xeoncesta/8085-POV/IMG_20170409_183915.jpg

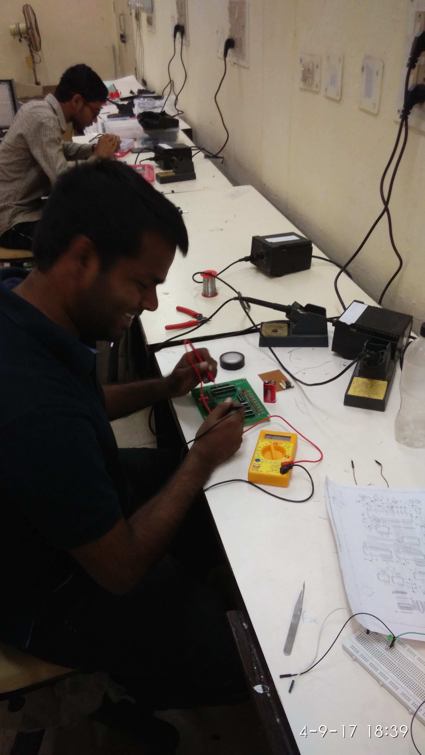
IMG_20170409_183915.jpg
