xeoncesta/8085-POV/README.md

# 8085-POV
Assembly Code and hardware implementation for 8085 MPU based POV Display.
