xeoncesta/8085-POV/IMG_20170522_213831.jpg

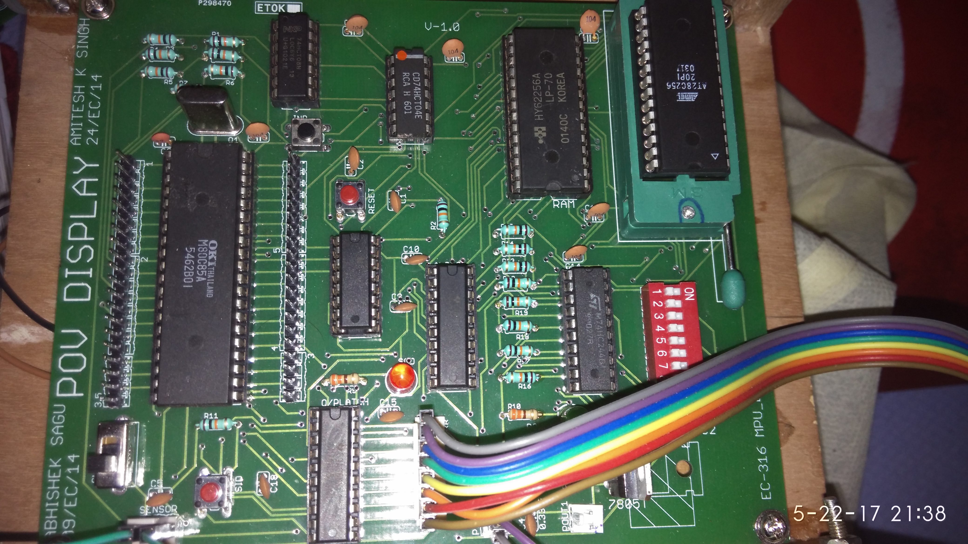
IMG_20170522_213831.jpg
