xeoncesta/8085-POV/ledunit.brd

## EAGLE design ledunit.brd (2017-05-22)

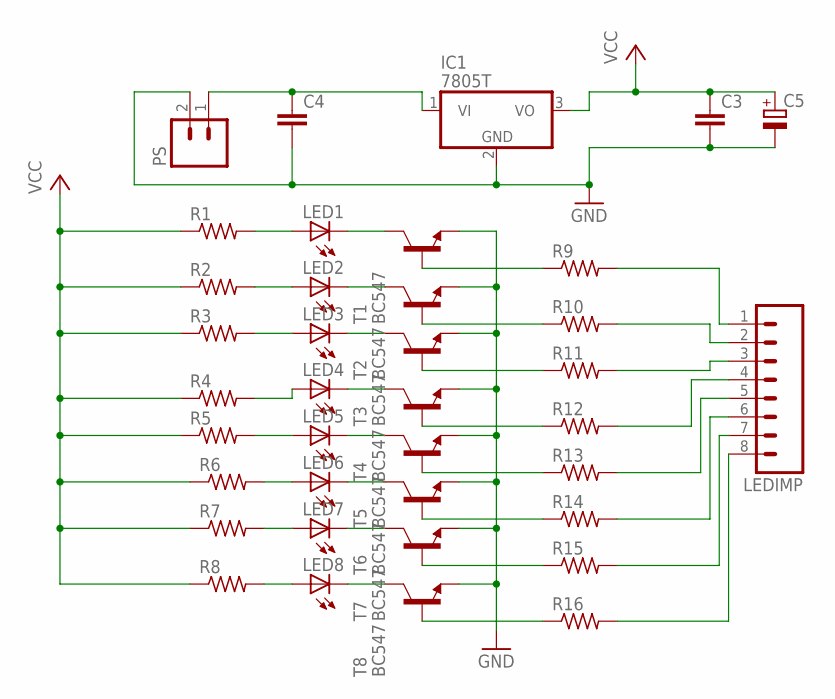
[picture p10: schematic ledunit.sch]

Parts:
C3, C4: C-EU025-024X044; C025-024X044
C5: CPOL-EUE2,5-6E; E2,5-6E
IC1: 7805T; TO220H
LED1, LED2, LED3, LED4, LED5, LED6, LED7, LED8: LED5MM
LEDIMP: M08; 08P
PS: M02; 02P
R1, R2, R3, R4, R5, R6, R7, R8, R9, R10, R11, R12, R13, R14, R15, R16: R-US_0204/7; 0204/7
T1, T2, T3, T4, T5, T6, T7, T8: BC547; TO92

Connections:
GND: C3.2, C4.2, C5.-, IC1.2 (GND), PS.2, T1.1 (E), T2.1 (E), T3.1 (E), T4.1 (E), T5.1 (E), T6.1 (E), T7.1 (E), T8.1 (E)
unnamed: LED8.A, R8.2
unnamed: LED7.A, R7.2
unnamed: LED6.A, R6.2
unnamed: LED5.A, R5.2
unnamed: LED4.A, R4.2
unnamed: LED3.A, R3.2
unnamed: LED2.A, R2.2
unnamed: LED1.A, R1.2
unnamed: LED1.K (C), T1.3 (C)
unnamed: LED2.K (C), T2.3 (C)
unnamed: LED3.K (C), T3.3 (C)
unnamed: LED4.K (C), T4.3 (C)
unnamed: LED5.K (C), T5.3 (C)
unnamed: LED6.K (C), T6.3 (C)
unnamed: LED7.K (C), T7.3 (C)
unnamed: LED8.K (C), T8.3 (C)
unnamed: R9.1, T1.2 (B)
unnamed: R10.1, T2.2 (B)
unnamed: R11.1, T3.2 (B)
unnamed: R12.1, T4.2 (B)
unnamed: R13.1, T5.2 (B)
unnamed: R14.1, T6.2 (B)
unnamed: R15.1, T7.2 (B)
unnamed: R16.1, T8.2 (B)
unnamed: LEDIMP.1, R9.2
unnamed: LEDIMP.2, R10.2
unnamed: LEDIMP.3, R11.2
unnamed: LEDIMP.4, R12.2
unnamed: LEDIMP.5, R13.2
unnamed: LEDIMP.6, R14.2
unnamed: LEDIMP.7, R15.2
unnamed: LEDIMP.8, R16.2
unnamed: C4.1, IC1.1 (VI), PS.1
VCC: C3.1, C5.+, IC1.3 (VO), R1.1, R2.1, R3.1, R4.1, R5.1, R6.1, R7.1, R8.1

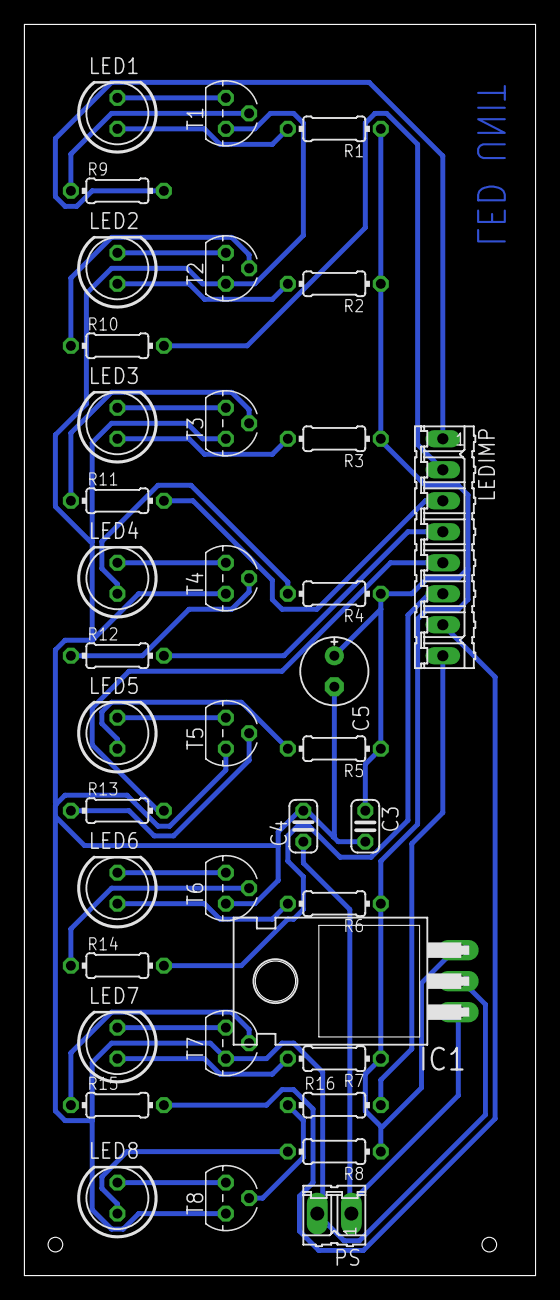
[picture p11: board ledunit.brd from above]

Board: 2 copper layers, 41.9 x 102.5 mm, 38 parts (0 on the bottom side), 35 nets.
