xeoncesta/8085-POV/POV_2.0.brd

## EAGLE design POV_2.0.brd (2017-05-22)

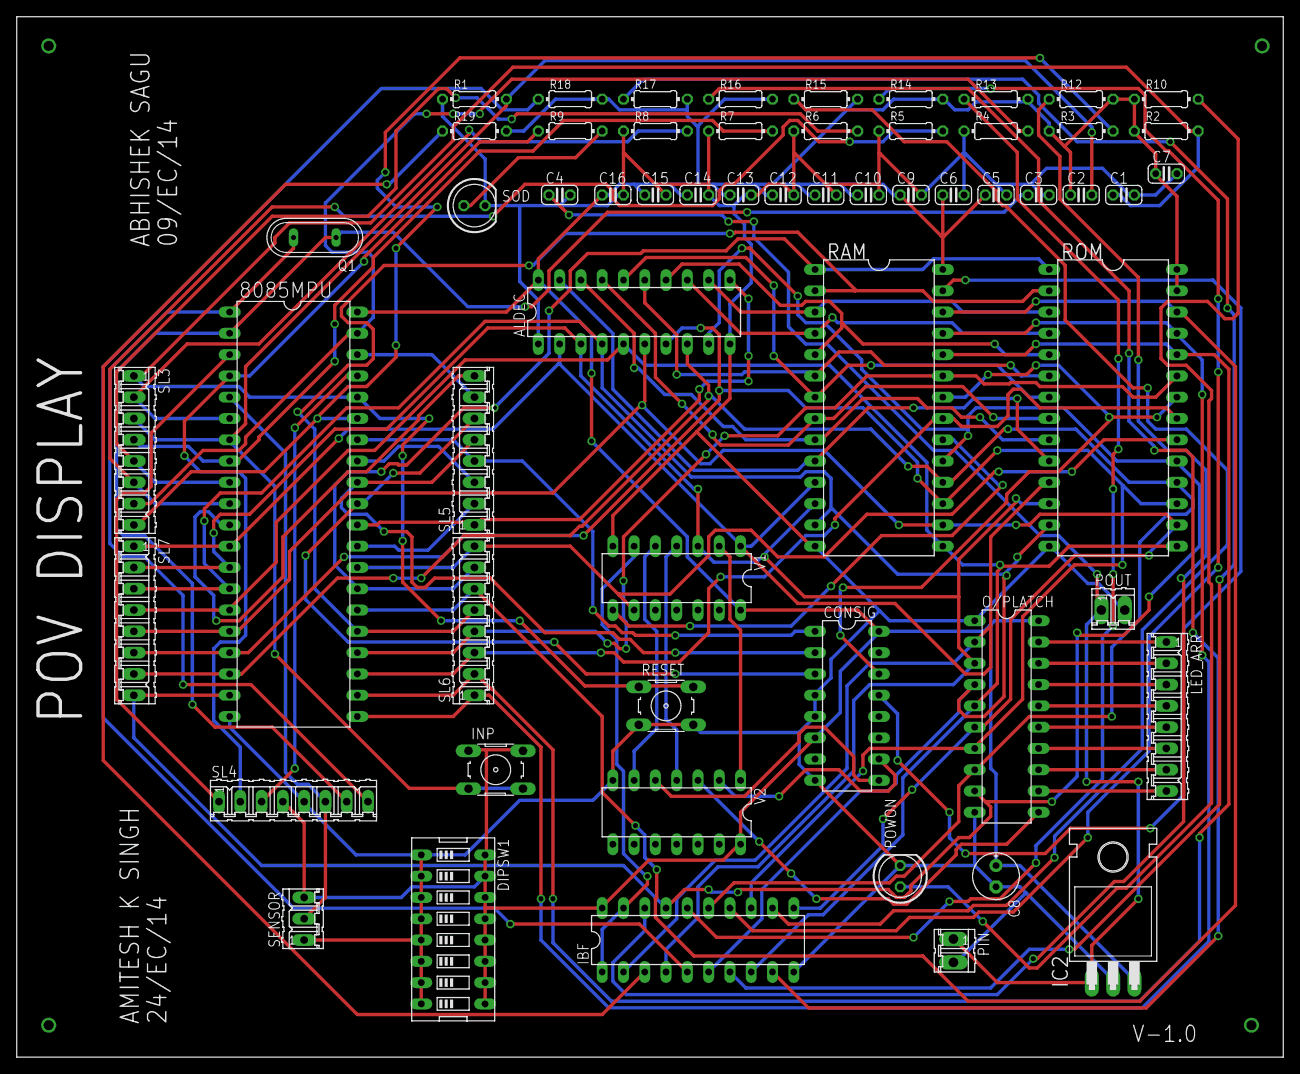
[picture p12: board POV_2.0.brd from above]

Board: 2 copper layers, 151.1 x 124.1 mm, 59 parts (0 on the bottom side), 77 nets.

Parts:
8085MPU: DIL40
ALDEC: 74HCT573N; DIL20
C1, C2, C3, C5, C6, C9, C10, C11, C12, C13, C14, C15, C16: C025-024X044
C4, C7: 0.01uF; C025-024X044
C8: 10uF; E2,5-6E
CONSIG: 74HCT138N; DIL16
DIPSW1: EDG-08
IBF: 74HCT244N; DIL20
IC2: 7805T; TO220H
INP: B3F-10XX
LED_ARR: 08P
O/PLATCH: 74HCT573N; DIL20
PIN: 02P
POUT: 02P
POWON: LED5MM
Q1: QS
R1, R2, R3, R4, R5, R6, R7, R8, R9, R10, R12, R13, R14, R15, R16, R17, R18, R19: 0204/7
RAM: DIL28-6
RESET: B3F-10XX
ROM: DIL28-6
SENSOR: 03P
SL3, SL4, SL5, SL6, SL7: 08P
SOD: LED5MM
V1: 7404N; DIL14
V2: 74HCT00N; DIL14

Connections:
A8: 8085MPU.21, RAM.25, ROM.25, SL6.1
A9: 8085MPU.22, RAM.24, ROM.24, SL6.2
A10: 8085MPU.23, RAM.21, ROM.21, SL6.3
A11: 8085MPU.24, RAM.23, ROM.23, SL6.4
A12: 8085MPU.25, RAM.2, ROM.2, SL6.5
A13: 8085MPU.26, RAM.26, ROM.26, SL6.6
A14: 8085MPU.27, RAM.1, ROM.1, SL6.7
A15: 8085MPU.28, ROM.20, SL6.8, V1.9
AD0: 8085MPU.12, ALDEC.2, IBF.2, O/PLATCH.2, RAM.11, ROM.11, SL7.1, V1.1
AD1: 8085MPU.13, ALDEC.3, IBF.4, O/PLATCH.3, RAM.12, ROM.12, SL7.2, V1.3
AD2: 8085MPU.14, ALDEC.4, IBF.6, O/PLATCH.4, RAM.13, ROM.13, SL7.3
AD3: 8085MPU.15, ALDEC.5, IBF.8, O/PLATCH.5, RAM.15, ROM.15, SL7.4
AD4: 8085MPU.16, ALDEC.6, IBF.11, O/PLATCH.6, RAM.16, ROM.16, SL7.5
AD5: 8085MPU.17, ALDEC.7, IBF.13, O/PLATCH.7, RAM.17, ROM.17, SL7.6
AD6: 8085MPU.18, ALDEC.8, IBF.15, O/PLATCH.8, RAM.18, ROM.18, SL7.7
AD7: 8085MPU.19, ALDEC.9, IBF.17, O/PLATCH.9, RAM.19, ROM.19, SL7.8
ALE: 8085MPU.30, ALDEC.11, SL5.1
CA15: RAM.20, V1.8
CLK: 8085MPU.37, SL4.3
GND: 8085MPU.20, ALDEC.1, ALDEC.10, C1.2, C3.2, C4.2, C5.2, C6.2, C7.2, C8.-, C9.2, C10.2, C11.2, C12.2, C13.2, C14.2, C15.2, C16.2, CONSIG.4, CONSIG.5, CONSIG.8, DIPSW1.1, DIPSW1.2, DIPSW1.3, DIPSW1.4, DIPSW1.5, DIPSW1.6, DIPSW1.7, DIPSW1.8, IBF.10, IC2.2, O/PLATCH.1, O/PLATCH.10, PIN.2, POUT.2, POWON.K, R1.1, R4.1, R5.1, R6.1, R7.1, R8.1, RAM.14, RESET.3, RESET.4, ROM.14, SENSOR.1, SL4.5, SOD.K, V1.7, V2.7
HLDA: 8085MPU.38, SL5.7
HOLD: 8085MPU.39, R4.2, SL3.7
INTA: 8085MPU.11, SL5.8
INTR: 8085MPU.10, R5.2, SL3.6
IO/M: 8085MPU.34, CONSIG.1, SL5.4
IOR: CONSIG.9, V2.5
IOW: CONSIG.10, V2.2
IPBE: V1.5, V2.6
MR: CONSIG.14, RAM.22, ROM.22
MW: CONSIG.13, RAM.27
unnamed: LED_ARR.1, O/PLATCH.19
unnamed: LED_ARR.2, O/PLATCH.18
unnamed: LED_ARR.3, O/PLATCH.17
unnamed: LED_ARR.4, O/PLATCH.16
unnamed: LED_ARR.5, O/PLATCH.15
unnamed: LED_ARR.6, O/PLATCH.14
unnamed: LED_ARR.7, O/PLATCH.13
unnamed: LED_ARR.8, O/PLATCH.12
unnamed: ALDEC.19, RAM.10, ROM.10
unnamed: ALDEC.18, RAM.9, ROM.9
unnamed: ALDEC.17, RAM.8, ROM.8
unnamed: ALDEC.16, RAM.7, ROM.7
unnamed: ALDEC.15, RAM.6, ROM.6
unnamed: ALDEC.14, RAM.5, ROM.5
unnamed: ALDEC.13, RAM.4, ROM.4
unnamed: ALDEC.12, RAM.3, ROM.3
unnamed: IBF.18, R12.1
unnamed: IBF.16, R13.1
unnamed: IBF.14, R14.1
unnamed: IBF.12, R15.1
unnamed: IBF.9, R16.1
unnamed: IBF.7, R17.1
unnamed: IBF.5, R18.1
unnamed: IBF.1, IBF.19, V1.6
unnamed: IBF.3, R19.1
unnamed: R9.2, SOD.A
unnamed: C4.1, IC2.1, PIN.1, POUT.1
unnamed: POWON.A, R10.2
unnamed: V1.2, V2.1
unnamed: V1.4, V2.4
OPLE: O/PLATCH.11, V2.3
RD: 8085MPU.32, CONSIG.2, SL5.5
READY: 8085MPU.35, R3.2, SL3.8
RES_IN: 8085MPU.36, C1.1, R2.2, RESET.1, RESET.2, SL3.1
RES_OUT: 8085MPU.3, SL4.1
RST5.5: 8085MPU.9, R6.2, SL3.5
RST6.5: 8085MPU.8, R7.2, SL3.4
RST7.5: 8085MPU.7, C2.2, INP.3, INP.4, R1.2, SL3.3
S0: 8085MPU.29, SL5.2
S1: 8085MPU.33, SL5.3
SID: 8085MPU.5, SENSOR.2, SL4.6
SOD: 8085MPU.4, R9.1, SL4.2
TRAP: 8085MPU.6, R8.2, SL3.2
VCC: 8085MPU.40, ALDEC.20, C2.1, C5.1, C6.1, C7.1, C8.+, C9.1, C10.1, C11.1, C12.1, C13.1, C14.1, C15.1, C16.1, CONSIG.6, CONSIG.16, DIPSW1.9, DIPSW1.10, DIPSW1.11, DIPSW1.12, DIPSW1.13, DIPSW1.14, DIPSW1.15, DIPSW1.16, IBF.20, IC2.3, INP.1, INP.2, O/PLATCH.20, R2.1, R3.1, R10.1, R12.2, R13.2, R14.2, R15.2, R16.2, R17.2, R18.2, R19.2, RAM.28, ROM.27, ROM.28, SENSOR.3, SL4.4, V1.14, V2.14
WR: 8085MPU.31, CONSIG.3, SL5.6
X1: 8085MPU.1, Q1.2, SL4.8
X2: 8085MPU.2, C3.1, Q1.1, SL4.7
