xeoncesta/8085-POV/(commit log)

2017-05-22 Board File
    [POV_2.0.brd]
2017-05-22 Schematic File
    Open in Eagle CAD
    [POV_2.0.sch]
2017-05-22 External Unit
    Add external unit as per need.
    [ledunit.brd, ledunit.sch]
2017-05-22 ASSEMBLY CODE FOR 8085 MPU
    Assembly Code for the POV display unit.
